ideaGarageIO/GateMonitor/hardware/pcb/gate_node_carrier/gate_node_carrier.kicad_pcb

## KiCad design hardware/pcb/gate_node_carrier/gate_node_carrier.kicad_pcb (2026-11-12)

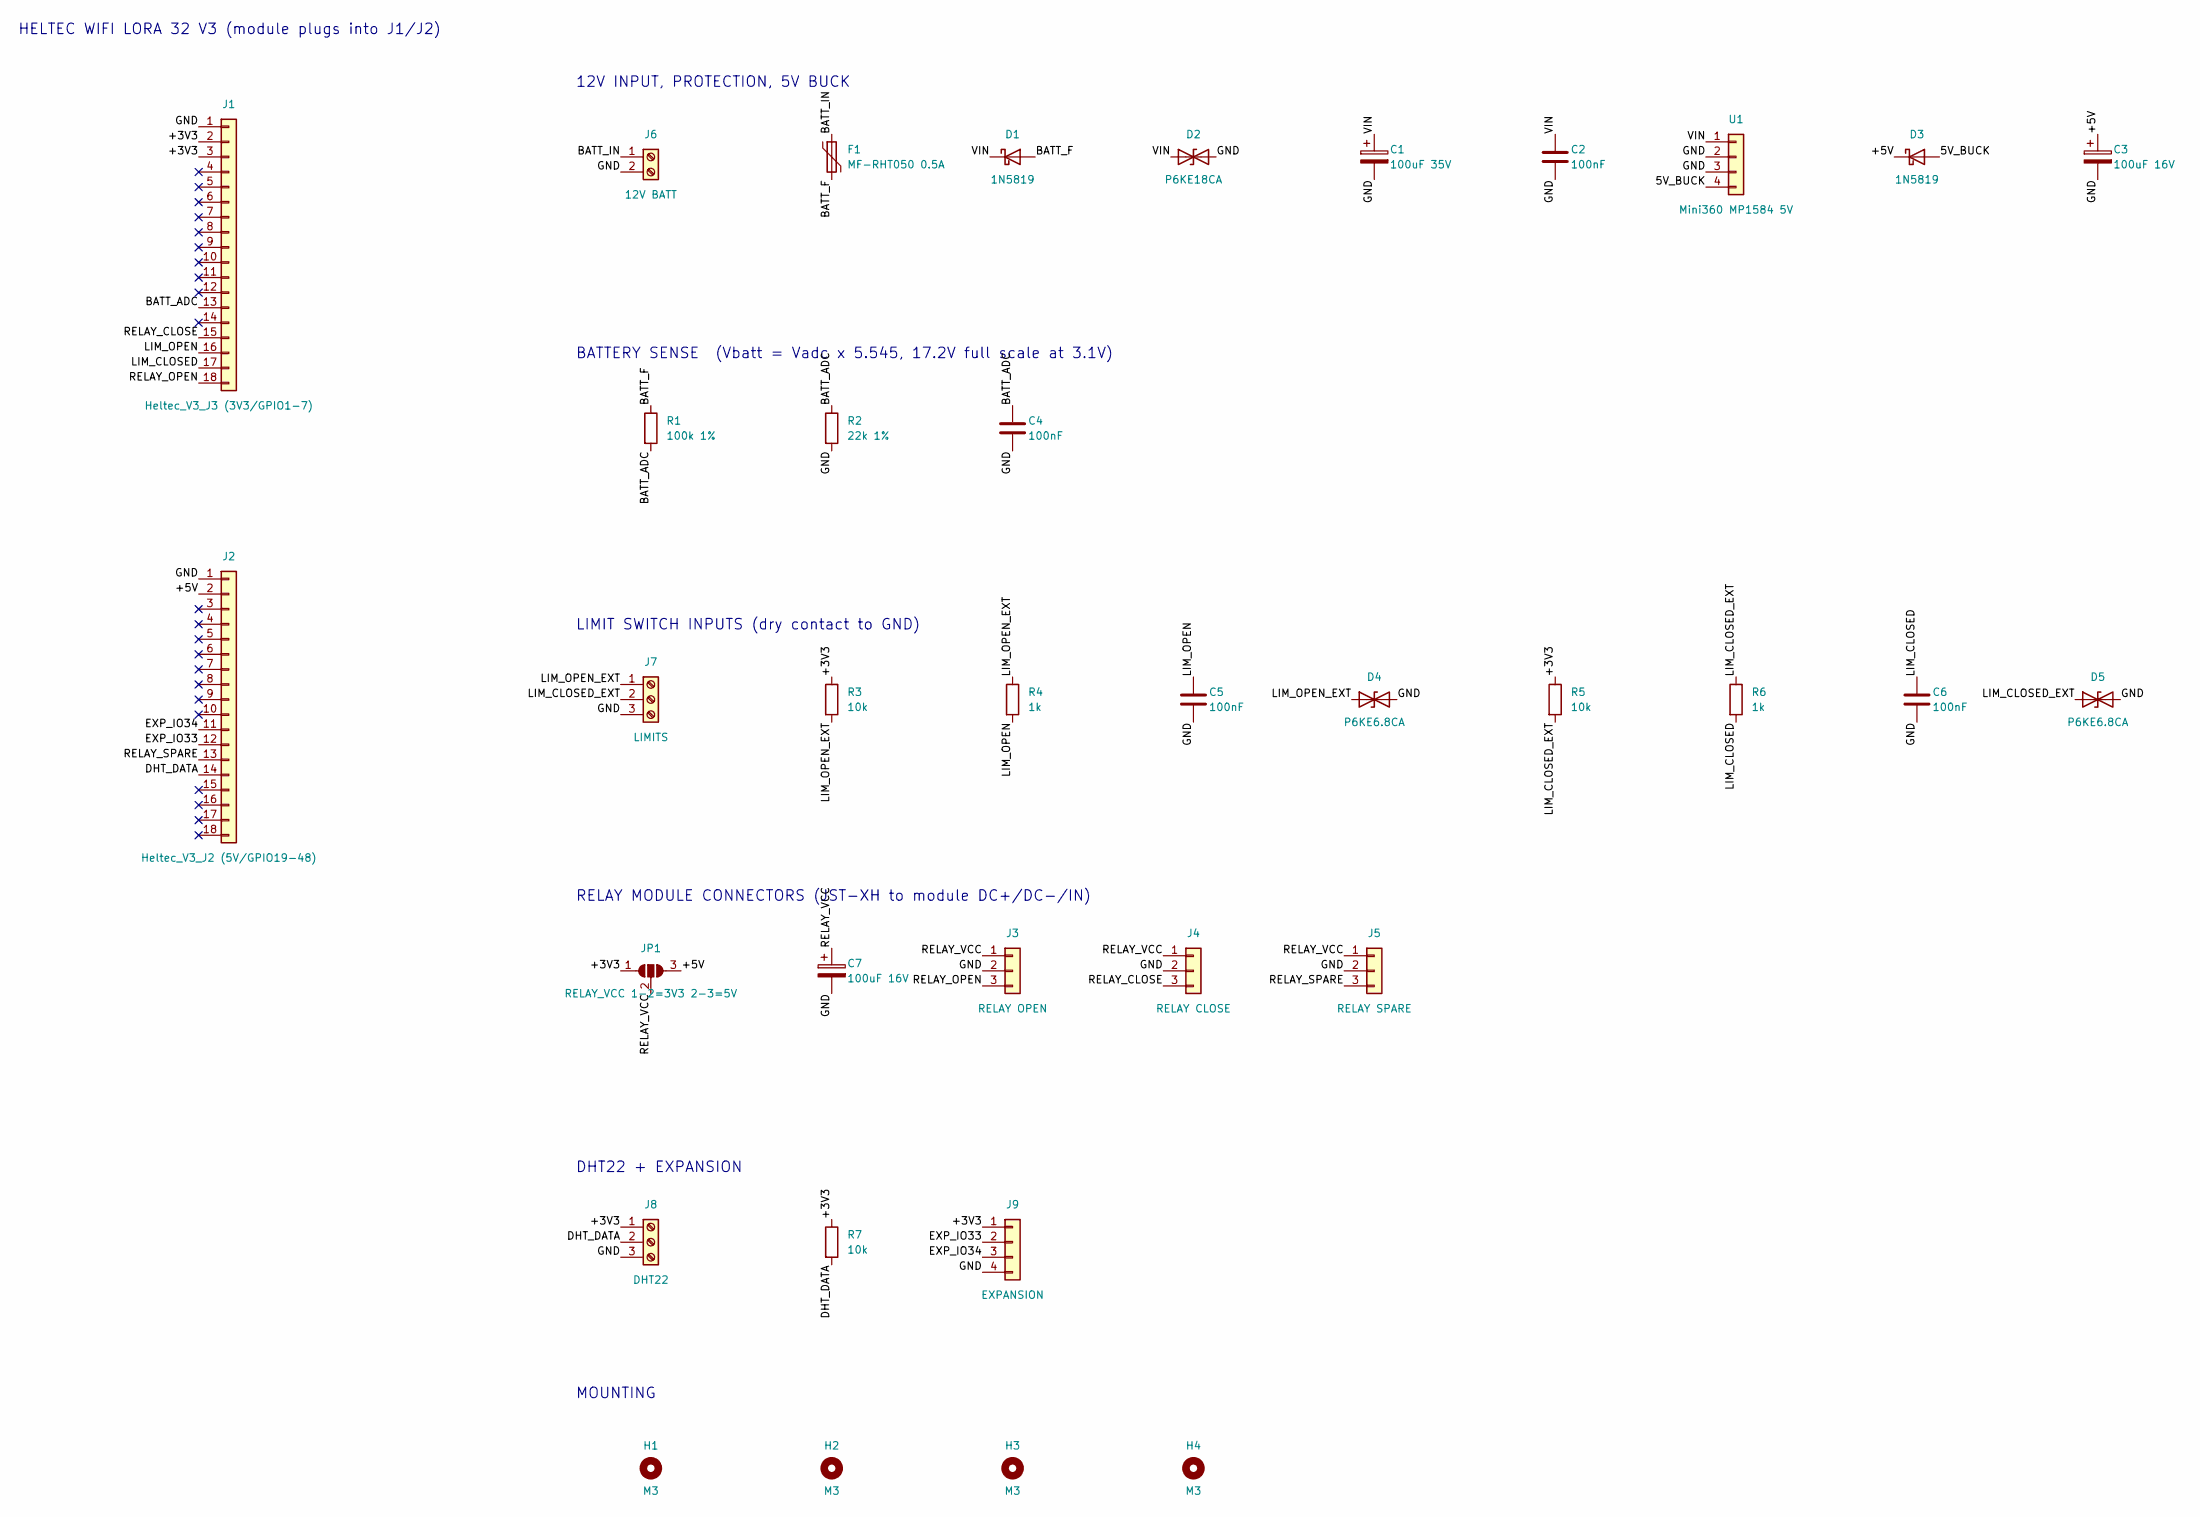
[picture p1: schematic gate_node_carrier.kicad_sch, Gate Node Carrier]

Parts:
C1: 100uF 35V; CP_Radial_D6.3mm_P2.50mm
C2, C4, C5, C6: 100nF; C_Disc_D5.0mm_W2.5mm_P5.00mm
C3, C7: 100uF 16V; CP_Radial_D6.3mm_P2.50mm
D1, D3: 1N5819; D_DO-41_SOD81_P10.16mm_Horizontal
D2: P6KE18CA; D_DO-15_P10.16mm_Horizontal
D4, D5: P6KE6.8CA; D_DO-15_P10.16mm_Horizontal
F1: MF-RHT050 0.5A; Fuse_Bourns_MF-RHT050
H1, H2, H3, H4: M3; MountingHole_3.2mm_M3
J1: Heltec_V3_J3 (3V3/GPIO1-7); PinSocket_1x18_P2.54mm_Vertical
J2: Heltec_V3_J2 (5V/GPIO19-48); PinSocket_1x18_P2.54mm_Vertical
J3: RELAY OPEN; JST_XH_B3B-XH-A_1x03_P2.50mm_Vertical
J4: RELAY CLOSE; JST_XH_B3B-XH-A_1x03_P2.50mm_Vertical
J5: RELAY SPARE; JST_XH_B3B-XH-A_1x03_P2.50mm_Vertical
J6: 12V BATT; TerminalBlock_Phoenix_MKDS-1,5-2-5.08_1x02_P5.08mm_Horizont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
J7: LIMITS; TerminalBlock_Phoenix_MKDS-1,5-3-5.08_1x03_P5.08mm_Horizont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
J8: DHT22; TerminalBlock_Phoenix_MKDS-1,5-3-5.08_1x03_P5.08mm_Horizont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
J9: EXPANSION; PinHeader_1x04_P2.54mm_Vertical
JP1: RELAY_VCC 1-2=3V3 2-3=5V; SolderJumper-3_P1.3mm_Open_RoundedPad1.0x1.5mm
R1: 100k 1%; R_Axial_DIN0207_L6.3mm_D2.5mm_P7.62mm_Horizontal
R2: 22k 1%; R_Axial_DIN0207_L6.3mm_D2.5mm_P7.62mm_Horizontal
R3, R5, R7: 10k; R_Axial_DIN0207_L6.3mm_D2.5mm_P7.62mm_Horizontal
R4, R6: 1k; R_Axial_DIN0207_L6.3mm_D2.5mm_P7.62mm_Horizontal
U1: Mini360 MP1584 5V; Mini360_MP1584

Connections:
5V_BUCK: D3.2 (A), U1.4
+3V3: J1.2, J1.3, J8.1, J9.1, JP1.1 (A), R3.1, R5.1, R7.1
+5V: C3.1, D3.1 (K), J2.2, JP1.3 (B)
BATT_ADC: C4.1, J1.13, R1.2, R2.1
BATT_F: D1.2 (A), F1.2, R1.1
BATT_IN: F1.1, J6.1
DHT_DATA: J2.14, J8.2, R7.2
EXP_IO33: J2.12, J9.2
EXP_IO34: J2.11, J9.3
GND: C1.2, C2.2, C3.2, C4.2, C5.2, C6.2, C7.2, D2.2 (A2), D4.2 (A2), D5.2 (A2), J1.1, J2.1, J3.2, J4.2, J5.2, J6.2, J7.3, J8.3, J9.4, R2.2, U1.2, U1.3
LIM_CLOSED: C6.1, J1.17, R6.2
LIM_CLOSED_EXT: D5.1 (A1), J7.2, R5.2, R6.1
LIM_OPEN: C5.1, J1.16, R4.2
LIM_OPEN_EXT: D4.1 (A1), J7.1, R3.2, R4.1
RELAY_CLOSE: J1.15, J4.3
RELAY_OPEN: J1.18, J3.3
RELAY_SPARE: J2.13, J5.3
RELAY_VCC: C7.1, J3.1, J4.1, J5.1, JP1.2 (C)
VIN: C1.1, C2.1, D1.1 (K), D2.1 (A1), U1.1

Notes on the sheet:
HELTEC WIFI LORA 32 V3 (module plugs into J1/J2)
12V INPUT, PROTECTION, 5V BUCK
BATTERY SENSE (Vbatt = Vadc x 5.545, 17.2V full scale at 3.1V)
LIMIT SWITCH INPUTS (dry contact to GND)
RELAY MODULE CONNECTORS (JST-XH to module DC+/DC-/IN)
DHT22 + EXPANSION
MOUNTING

Board: 2 copper layers, 35 parts (0 on the bottom side), 19 nets, no tracks yet.
