ideaGarageIO/GateMonitor/(commit log)

2026-11-11 feat: adding some updated features feat: adding PCB
    [gate_node_carrier.kicad_pcb, gate_node_carrier.kicad_sch]
2026-11-11 feat: working on 3d model for board.
    [gate_node_carrier.kicad_pcb]
2026-11-12 feat: Moving the server to typescript and react to be responsive.
    [gate_node_carrier.kicad_pcb]
